vlrmprjct/trix-control-unit/doc/arduino_mega_2560_pinout.jpg

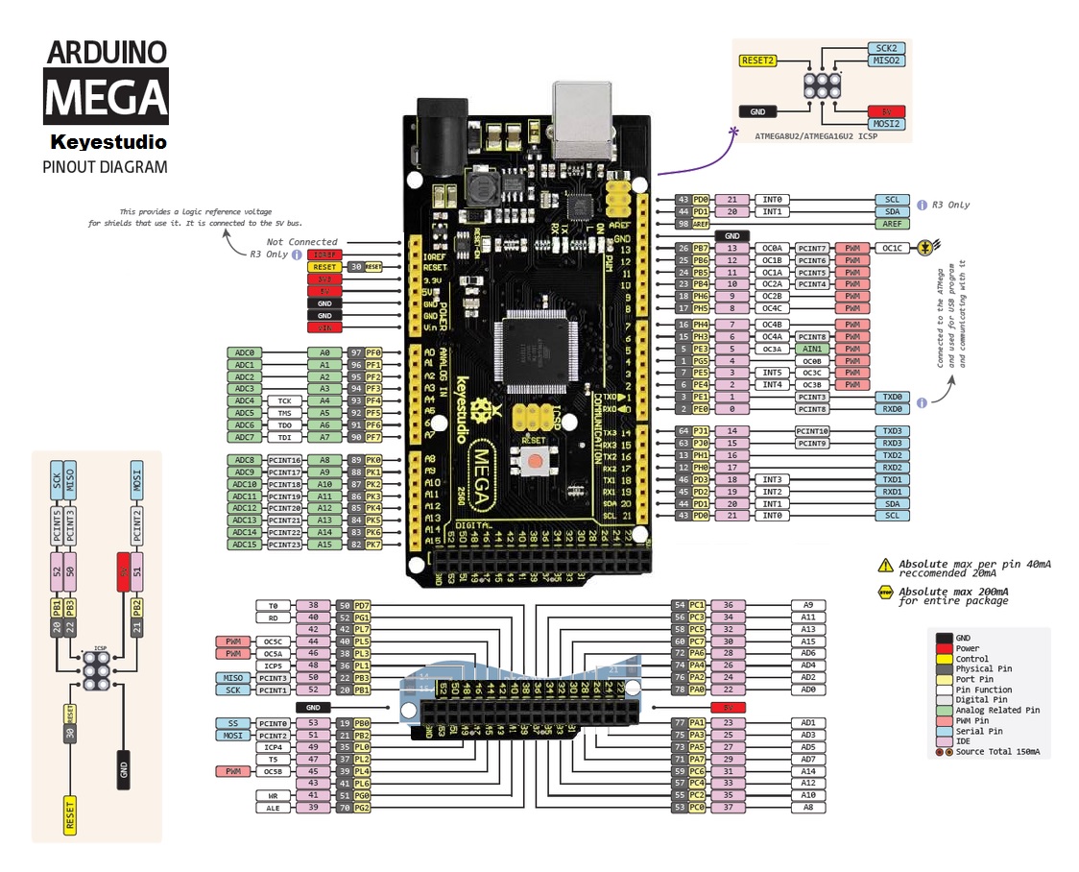
doc/arduino_mega_2560_pinout.jpg
