vlrmprjct/trix-control-unit/code/src/core/config.h

#pragma once

// FIRMWARE VERSION ################################################################################
#define FIRMWARE_VERSION "v1.3.2"

// EEPROM SETUP ###################################################################################
// EEPROM VERSION
constexpr unsigned long ROUTE_MAGIC    = 0xDEADBEEF;
constexpr unsigned short ROUTE_VERSION = 8;

// EEPROM ADDRESS CONSTANTS
constexpr int EEPROM_ROUTE   = 0;
constexpr int EEPROM_RELAY   = 1000;
constexpr int EEPROM_META    = 1500;
constexpr int EEPROM_DIGIPOT = 1600;   // 1-BYTE MARKER: MCP4261 NV WIPER ALREADY ZEROED


// CONTROL CONFIG SETUP ###########################################################################
// DASHBOARD BUTTON MODULE COUNT
const int BTN_COUNT = 24;

// REED SWITCHES MODULE COUNT
const int REED_COUNT = 32;

// RELAY MODULE COUNT
const int RELAY_COUNT = 24;

// ENCODER DEFAULTS
const int ENC_MIN = 40;
const int ENC_MAX = 255;


// DASHBOARD CONTROL UNIT / WIRE / PIN CONFIG #####################################################
// LCD DOT MATRIX
const int LCD_RS  = 34; // COMMON PIN FOR LCD1, LCD2, LCD3
const int LCD_EN  = 36; // COMMON PIN FOR LCD1, LCD2, LCD3
const int LCD1_D4 = 38;
const int LCD1_D5 = 40;
const int LCD1_D6 = 42;
const int LCD1_D7 = 44;

const int LCD_RST = 27;

// BUTTON CTRL
const int BTN_DATA   = 22;  // PURPLE
const int BTN_CLOCK  = 23;  // YELLOW
const int BTN_LATCH  = 24;  // GREEN


// TRACK UNIT / WIRE / PIN CONFIG #################################################################

// MOTOR CTRL PSU MCP4261XX (HARDWARE SPI)
// HARDWARE SPI PINS (ARDUINO MEGA):
// MOSI = PIN 51 (USED, DATA TO CHIPS)
// SCK  = PIN 52 (USED, CLOCK)
// MISO = PIN 50 (NOT USED, NO READBACK NEEDED)
const int DIGIPOT1_CS   = 33; // PURPLE  | CHIP 1 (ZONE_A, ZONE_B)
const int DIGIPOT2_CS   = 32; // PURPLE  | CHIP 2 (ZONE_C, ZONE_D)

// TRACK REED CTRL 74HC165
const int REED_DATA  = 41;  // PURPLE  | REED1-Board QH
const int REED2_DATA = 47;  // PURPLE  | REED2-Board QH
const int REED_CLOCK = 43;  // YELLOW  | SHARED
const int REED_LATCH = 45;  // ORANGE  | SHARED

// ENCODER ZONE A // MOUNTED LEFT
const int ENC_ZONE_A_CLK = 18; // GREEN  | INTERRUPT
const int ENC_ZONE_A_DT  = 28; // YELLOW
inline int ENC_ZONE_A_CLK_STATE;
inline volatile int ENC_ZONE_A = 0;

// ENCODER ZONE B // MOUNTED RIGHT
const int ENC_ZONE_B_CLK = 19; // GREEN  | INTERRUPT
const int ENC_ZONE_B_DT  = 29; // YELLOW
inline int ENC_ZONE_B_CLK_STATE;
inline volatile int ENC_ZONE_B = 0;

// SERVO MODULE [ NOT USED SOMEWHERE, JUST FOR PINOUT DOCUMENTATION ]
const int SERVO_SDA = 20;             // PURPLE
const int SERVO_SCL = 21;             // YELLOW
const int SERVO_VOLTAGE_INTERNAL = 5; // BROWN | 5V VOLTAGE PIN
const int SERVO_VOLTAGE_EXTERNAL = 5; // RED | 5V EXTERNAL VOLTAGE

// RELAY CTRL 74HC595
const int RELAY_LATCH = 39; // YELLOW
const int RELAY_DATA  = 37; // ORANGE
const int RELAY_CLOCK = 35; // PURPLE
