vlrmprjct/trix-control-unit/code/src/controls/buttonControl.h

#ifndef BUTTON_CONTROL_H
#define BUTTON_CONTROL_H

#include <Arduino.h>

namespace ButtonControl {
    long readButtons();
    void pushButton(int buttonNr, void (*callback)());
    void updateStates();
    void setStates();
}

#endif
