vlrmprjct/trix-control-unit/code/src/controls/reedControl.h

#ifndef REED_CONTROL_H
#define REED_CONTROL_H

#include <Arduino.h>

namespace ReedControl {
    long read();
    void push(int buttonNr, void (*callback)());
    void updateStates();
    void setStates();
}

#endif
