vlrmprjct/trix-control-unit/code/src/core/chars.h

#pragma once

#include <Arduino.h>

// CUSTOM LCD CHARACTERS (HD44780 CGRAM INDEX 0-7)
const byte CHAR_CIRCLE_EMPTY  = 0; // EMPTY CIRCLE: FREE + POWERED
const byte CHAR_CIRCLE_FILLED = 1; // FILLED CIRCLE: OCCUPIED
const byte CHAR_ARROW_RIGHT   = 2; // ARROW RIGHT: SELECTED / PENDING

byte charCircleEmpty[8]  = { 0b00000, 0b01110, 0b10001, 0b10001, 0b10001, 0b01110, 0b00000, 0b00000 };
byte charCircleFilled[8] = { 0b00000, 0b01110, 0b11111, 0b10001, 0b11111, 0b01110, 0b00000, 0b00000 };
byte charArrowRight[8]   = { 0b00000, 0b10000, 0b11000, 0b11100, 0b11000, 0b10000, 0b00000, 0b00000 };
