vlrmprjct/trix-control-unit/code/src/utils/eeprom.cpp

#include "../core/config.h"
#include "../core/state.h"
#include <Arduino.h>
#include <EEPROM.h>

namespace Eeprom {

    void reset() {
        for (int i = 1; i <= 10; ++i) {
            ROUTE.track[i].occupied = false;
            ROUTE.track[i].selected = false;
            ROUTE.track[i].powered  = false;
            ROUTE.track[i].pending  = false;
            ROUTE.track[i].name[0]  = '\0';
            ROUTE.track[i].uid[0]   = '\0';
            ROUTE.track[i].min      = 0;
            ROUTE.track[i].max      = 0;
            ROUTE.track[i].brake    = 0;
        }
    }

    void load() {
        RouteMeta META;
        EEPROM.get(EEPROM_META, META);

        if (META.magic != ROUTE_MAGIC || META.version != ROUTE_VERSION) {
            Serial.println(F("EEPROM: Invalid versioning - setting defaults"));

            reset();

            META.magic = ROUTE_MAGIC;
            META.version = ROUTE_VERSION;

            EEPROM.put(EEPROM_ROUTE, ROUTE);
            EEPROM.put(EEPROM_META, META);
        } else {
            EEPROM.get(EEPROM_ROUTE, ROUTE);
        }
    }

    void save() {
        EEPROM.put(EEPROM_ROUTE, ROUTE);
    }

    void clear() {
        for (int i = 0; i < EEPROM.length(); i++) {
            EEPROM.write(i, 0xFF);
        }
        Serial.println(F("EEPROM completely wiped"));
    }
}
