vlrmprjct/trix-control-unit/(commit log)

2025-03-03 clean up relay control, reverse relay ordering
    [relayControl.cpp]
2025-04-04 lcd display, encoder, speed measure, relay test
2025-04-07 Switch to DRV8871 motordriver module
2025-04-15 add servocontrol poc
2025-04-15 remove obsolete poti motor control
2025-04-15 add comment init motor module
2025-04-15 change servo params
2025-04-15 add missing relay setup
    [code.ino]
2025-04-30 add pin comments @ config
2025-05-14 add 2 motorcontrols
2025-05-17 add working button control
2025-05-18 fix servo angel
2025-05-18 init track turnout switches
2025-05-18 change to plain connected lcd, remove lcd-i2c
2025-05-24 change pin description
2025-05-25 change speed naming, fix empty speed value
    [code.ino]
2025-05-25 move encoder control to file
2025-06-12 add namespace @ motorcontrol
2025-06-17 fix params @ motorControl
    [code.ino, motorControl.h]
2025-06-18 reed control changes, fix button order
    [code.ino, config.h, reedControl.cpp]
2025-06-20 Change Pin4 to Pin 8 due timer conflict
2025-06-20 Decrease min encoder value
2025-06-20 add timer prescaler util
2025-06-20 fix prescaler util naming
    [code.ino]
2025-06-20 change buttonControl to namespace
2025-06-22 rename all hardware contols, add hardware buttons
2025-06-22 add motor ramp down, smooth braking
2025-06-24 changes because of some hardware replacements
    [code.ino, config.h]
2025-06-28 revert to pin 2,3
    [config.h]
2025-06-28 reverse order of relais
    [relayControl.cpp]
2025-06-28 fix relais init, set eeprom address as const
    [code.ino]
2025-06-29 fix typo @ utils.h
    [utils.h]
2025-06-29 add relay state eeprom address
2025-06-29 add relaycontrol namepace
2025-06-29 working hbf1 using relay
2025-06-30 rename motorctrl ramp value
2025-07-03 add brake function rampDynamicValue
2025-07-03 change brake deceleration value
2025-07-03 use deceleration to brake
2025-07-04 fix brake value
2025-07-14 change frequency, sync timer
2025-07-18 sync encoder direction, refactor encodercontrol
2025-07-18 fix lcd text align
    [lcdControl.cpp]
2025-09-22 change servo angle, finetuning
2025-10-13 rewiring, draft new motorcontrol
2025-10-13 add new digital poti motorcontrol, remove pwm controled mdl, naming zones
2025-10-13 optimize encoder value handling
2025-10-16 add working BBF switches 1 to 3
2025-10-17 change servo min max angle
2026-03-15 add angel offset to servo control
2026-04-05 Add dual reed board support, extend button shiftregister to 24, translate docs to English
2026-04-10 fix: remove inline ramp vars
    [code.ino, motorControl.cpp, motorControl.h]
2026-04-14 featt. add new motorcontrol odul, zone c and zone d
2026-04-14 feat: change to hardware SPI
2026-04-19 fix: remove unused int value percent
    [code.ino]
2026-04-19 fix: cleanup messy HBFx/BBFx lcd print
    [code.ino]
2026-04-19 fix: move core files
    [blockControl.h, buttonControl.cpp, code.ino, config.h, debug.cpp, eeprom.cpp, encoderControl.cpp, init.h]
2026-04-21 feat: add track doc as svg
2026-04-22 fix: webserial sending issue
    [webState.cpp]
2026-04-24 feat: lcd show track state
2026-04-24 fix: add cancel pending depart
    [code.ino, trackControl.cpp, trackControl.h]
2026-04-24 fix: refactor track state control
    [trackControl.cpp]
2026-05-24 fix turnouts, add block logic, code cleanup
    [code.ino, init.h]
2026-05-26 fix wrong relay 9 trigger
    [code.ino]
2026-06-04 fix turnout angle, add hbf autoselection
    [code.ino]
2026-06-05 add servo calibration config file
2026-06-14 feat: Softstart with log ramp, relay naming, W2/Block-A departure guards, per-HBF departure tracking, boot state sync
2026-06-15 refactor: move departingSlot to TrackControl, replace ramp API, add releaseZoneA for BBF parking path
    [code.ino, motorControl.cpp, motorControl.h, trackControl.cpp, trackControl.h]
2026-06-15 fix: guard releaseZoneA in RD_BBFx_L, only trigger on stop, not pass-through
    [code.ino]
2026-07-18 feat: v1.3.0, BBF pass-through routing fix (powered sync), trackControl refactor
    [code.ino, config.h, servocal.h, trackControl.cpp, trackControl.h]
2026-07-18 fix: eliminate MCP4261 cold-boot ~6V , one-time NV wiper=0 (EEPROM guarded)
    [config.h, init.h, motorControl.cpp, motorControl.h]
2026-07-18 fix: BBF stop-request survives RD_05 re-routing, guard powered in setBBFEntryRoute (v1.3.2)
    [config.h, trackControl.cpp]
